SoporteColnodo/sensor-PM-SDS011/README.md

# Sensor-aire-rds
 Mediante esta pagina se pueden consultar los resultados del sensor de aire a tiempo real
 https://api.rds.org.co/reportes?categoria=sensor-aire
