SoporteColnodo/sensor-PM-SDS011/Manual técnico sensor material particulado.pdf

## ALERTAS AMBIENTALES: MANUAL TÉCNICO Y DE ENSAMBLAJE SENSOR PM 10 Y PM 2.5

¿Por qué nace el proyecto?

Este proyecto se enmarca dentro del concepto de las ciencias ciudadanas, una herramienta donde las comunidades son parte fundamental de cualquier investigación y participan activamente en el proceso de recolección y análisis de datos sobre problemáticas que afectan su calidad de vida, haciendo uso de sensores de bajo costo y accesibles.

Estos dispositivos están al servicio de comunidades para abordar ciertas preocupaciones como la contaminación por material particulado y sus integrantes pueden hacer uso de estos recursos informativos, trabajarlos, compartirlos y apropiarse de ellos en la defensa de sus territorios. En este manual se describen los elementos y pasos necesarios ensamblar un sensor de material particulado, que captura datos de PM 10 y PM 2.5, acompañados de coordenadas (latitud y longitud), identificación del sensor, fecha y hora, para ser almacenados dentro de una tarjeta microSD o ser enviados al servidor de mapas.

Elementos que componen el sensor de material particulado

Los elementos necesarios para ensamblar el sensor de ruido serán descritos a continuación:

- Microcontrolador

Una placa ESP32 (Figura 1), la cuál es un microcontrolador de 32 bits mucho más robusto y económico en procesamiento, módulos hardware y resolución ADC al contar con un conversor de 12 bits en vez de uno de 8 bits. Se opta por esta opción debido a la cantidad de módulos que irán ensamblados, capacidad de procesamiento y precisión de lecturas frente al Arduino MEGA y Arduino UNO. Se recomienda no hacer uso de las ESP 32 blancas.

Para su configuración, es necesario instalar un firmware en concreto para poder hacer uso de la tarjeta desde el IDE de Arduino, que será explicado más adelante.

- Sensor de posición

El sensor GPS propuesto es el Neo 6M (Figura 2) que funciona por comunicación serial UART. Tiene conexión directa satelital, motivo por el cual la lectura es bastante precisa y eficiente cuando inicia el proceso de lectura.

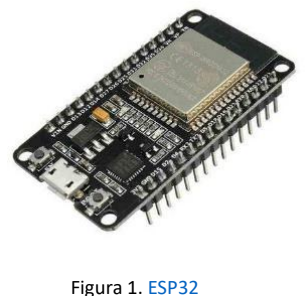
[picture p1: figure]

Figura 1. ESP32 (https://ferretronica.com/products/modulo-wifi-bluetooth-esp32)

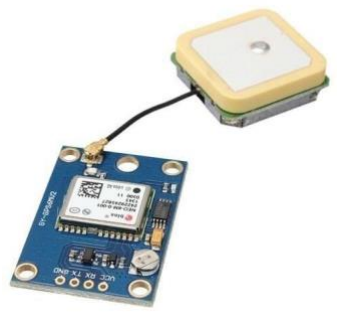
[picture p2: figure]

Figura 2. Sensor GPS Neo 6M (https://articulo.mercadolibre.com.co/MCO-452780792-modulo-gps-para-arduino-neo-6m-_JM)

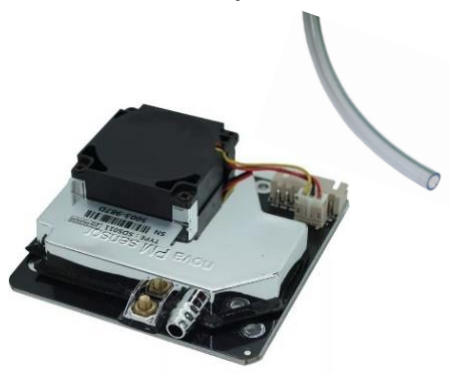
[picture p3: figure]

- Sensor de material particulado PM 10 y PM 2.5

Un sensor SDS011 Nova de PM (Figura 3), el cual captura material particulado de diámetro de 10 micrómetros y 2.5 micrómetros a partir de tecnología láser. En su interior contiene un ventilador, que de mayor tamaño al de otros sensores del mercado, lo cual implica que será mejor la calidad de los datos capturados

Es necesario adaptarle una manguera de diámetro 0.5 mm para la captura de aire.

- Reloj de tiempo real (RTC)

La captura de datos relacionados a la fecha y hora se hace a través de un módulo RTC DS1307 (figura 4) el cuál funciona por medio de la interfaz de comunicación I2C. Dicho módulo funciona perfectamente y es amigable para los usuarios; es importante que en las conexiones de I2C (SDA y SCL) se añadan resistencias de pull-up (10KOhm recomendado) para regular las diferencias de tensión.

- Lector de tarjeta SD

Para la tarjeta SD se utiliza un módulo de lectura/escritura de tarjeta SD, el cuál maneja protocolo de comunicación SPI. Hay que tener cuidado con este módulo ya que se vende el de tarjeta SD y microSD, los de tarjeta SD tienden a fallar por no estar bien adaptados a esos tamaños, cosa que no pasa con los microSD.

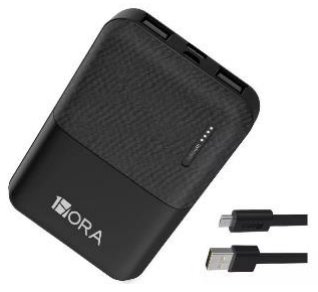
[picture p4: figure]

- Power Bank

PowerBank 5000 mAh dispositivo portátil para cargar dispositivos electrónicos mientras se está en movimiento. ofrece una fuente de energía adicional para teléfonos móviles, tabletas u otros dispositivos electrónicos (figura 6).

- Conector USB (Macho)

Conector que permite vincular diferentes elementos a través del Universal Serial Bus (USB), usado en el montaje para alimentar la tarjeta ESP32 de informacion y la corriente desde la power bank (figura 7).

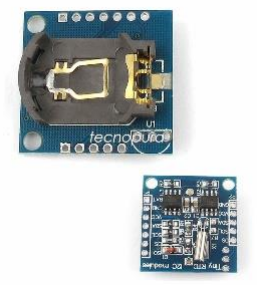
[picture p5: figure]
Figura 9. Power Bank

Figura 4. Módulo RTC DS1307 (https://www.tecnopura.com/producto/modulo-rtc-ds1307-reloj-en-tiempo-real-interface-i2c/)

Figura 3. Sensor (https://www.zamux.co/modulo-lectura-escritura-micro-sd) SDS011 Nova PM (https://www.mactronica.com.co/sensor-de-particulas-de-polvo-nova-pm-sds011)

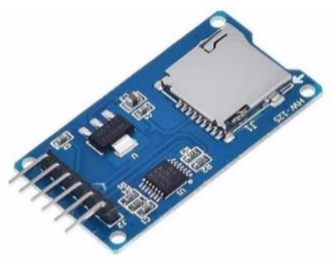
[picture p6: figure]

Figura 5. Módulo microSD (https://www.zamux.co/modulo-lectura-escritura-micro-sd)

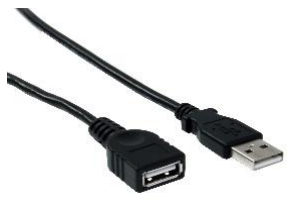
[picture p7: figure]

Figura 7. CABLES USB (https://www.mercadolibre.com.co/cable-sgl-extension-usb-3mts-a4s/p/MCO21521902)

Figura 6. Power Bank 500 mAh (https://articulo.mercadolibre.com.co/MCO-1200585124-power-bank-5000-mah-portable-original-1hora-facil-de-llevar-_JM)

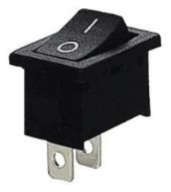
[picture p8: figure]

- Interruptor Encendido/Apagado

Mini Switch Interruptor Balancin 15mm x 10mm x 12mm para Chasis de 2 Pines y 2 Posiciones altamente empleado en Circuitos Electricos y Electronicos, usado en el prototipo en dar paso a la energia desde la power bank hacia el circuito (figura 8).

- Bornera de conexión con tornillo

Una clema (también conocido como bornera o regleta) es un tipo de conector eléctrico en el que un cable se aprisiona contra una pieza metálica mediante el uso de un tornillo.¹
Se implementa dentro del circuito para conexión cableada (figura 9).
- Cables de conexión para protoboard

Cables Dupont para Protoboard Macho/Macho, Hembra/Hembra, Macho/Hembra son cables jumper de 15cm de largo. Estos se usan para conectarse desde cualquier header hembra o macho en cualquier placa, usados dentro de el prototipo para la conexión de los módulos entre si y la protoboard.

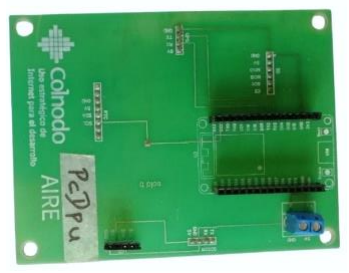
[picture p9: figure]

- PCB

Una PCB o Placa con circuito impreso, que funciona a manera de soporte fisico y de conexiones para ensamblar los componentes del dispositivo de ruido. Esta placa reemplaza la clasica protoboard con orificios que usa de pruebas y contiene las conexiones necesarias y esta contra marcada con logo de Colnodo.

- SD y adaptador

Un adaptador para tarjeta micro SD en el cual se almacenaran los archivos que se capturen con el sensor de ruido, esta tarjeta microSD tiene una capacidad de 8 gb (figura 12).

1 https://outletelectricidad.com/es/646-regletas-de-conexion

Figura 8. Interruptor
Encendido/Apagado (https://ferretronica.com/products/mini-switch-interruptor-balancin-15mm-x-10mm-x-12mm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)

Figura 9. Bornera de conexión con tornillo (https://articulo.mercadolibre.com.co/MCO-636537323-conector-terminal-bloque-bornera-kf302-2-pines-azul-tornillo-_JM)

Figura 10. Cables de conexión para protoboard (https://articulo.mercadolibre.com.co/MCO-623042255-cables-jumpers-m-h-10cm-x-40-unidades-_JM)

Figura 12. Adaptador
TarjetaMicro SD (https://www.mercadolibre.com.co/tarjeta-de-memoria-kingston-sdcs-canvas-select-con-adaptador-sd-32gb/p/MCO10359999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)

Figura 11. PCB

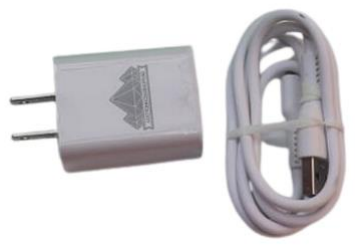
[picture p10: figure]
Figura 18. Cargador tipo 2

- Cargador y cable de conexión

El cargador funciona como un dispositivo que permite entregar corriente continua de bajo voltaje a otros dispositivos como es el caso de la Power Bank y recargarla; para transferencia de codigo tambien. La entrada del cargador es tipo 2.

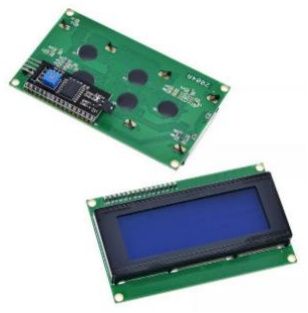
[picture p11: figure]

- Pantalla Display LCD

Una LCD o pantalla de cristal líquido, de referencia 4x20, es un componente que facilita la visualización de información o datos de una forma gráfica, haciendo uso de caracteres y símbolos configurados desde el código de programacipón en Arduino IDE (figura 14).

Esquemático de conexiones

A partir de pruebas realizadas en el circuito de pruebas, se propone el siguiente esquemático de conexiones para alimentar cuatro módulos respectivos y componentes pasivos como los diodos LED, condensadores, bornera y resistencias.

Figura 13. Cargador tipo 2

Figura 13. Pantalla LCD 4X20 (https://ferretronica.com/products/pantalla-display-lcd-4x20-verde)

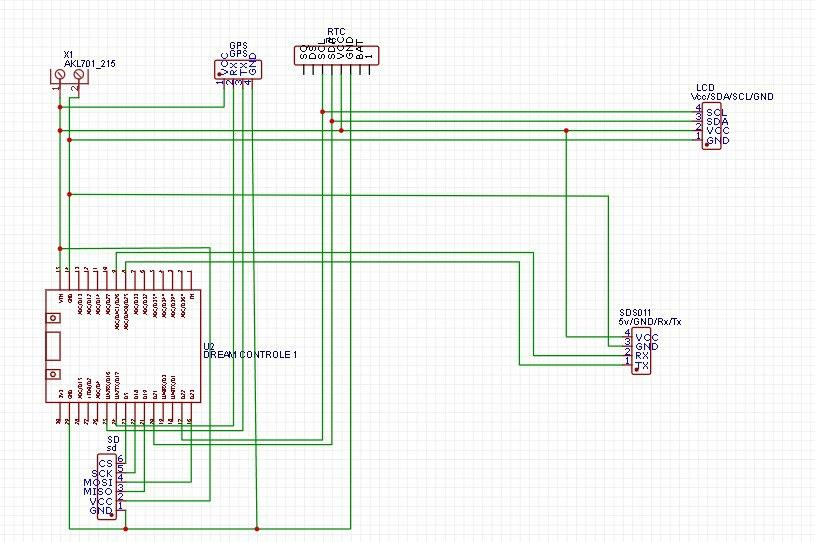
[picture p12: figure]

Diseño PCB (Placa con circuito impreso)

El diseño ha sido realizado en el software libre EasyEDA²
, en cual se pueden crear y simular circuitos para posteriormente diseñar la placa de circuito impreso y generar el archivo para su impresión.

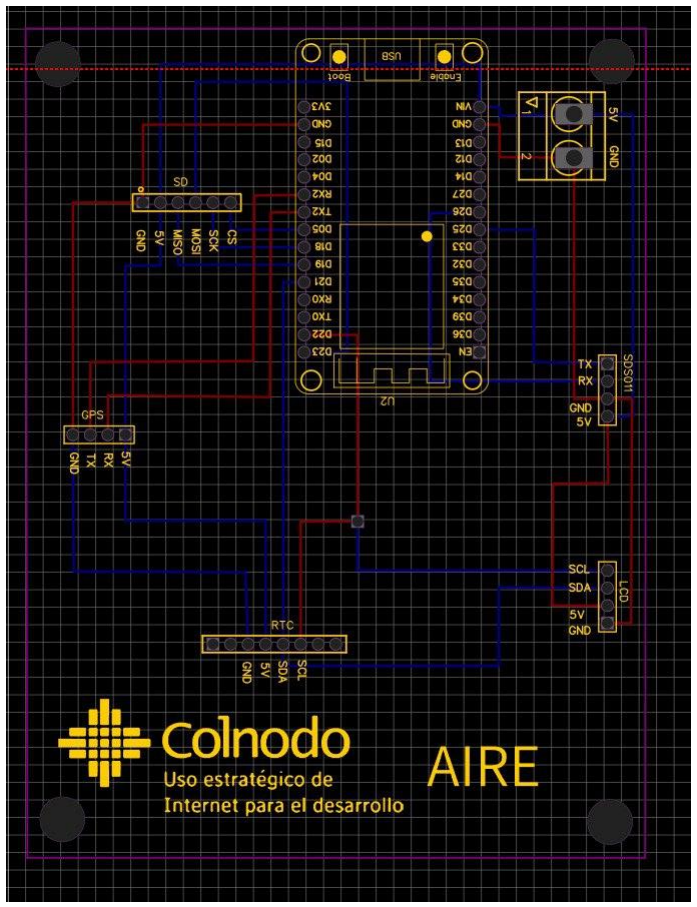
[picture p13: figure]

Enlace de descarga: https://easyeda.com/page/download

Esquemático en 3D

El diseño de esta PCB es de capa doble con conexiones y puntos de contacto en ambas caras, con la finalidad de que cada uno de los módulos encaje correctamente y contenga las conexiones correctas entre estos. A continuación, la vista por ambas caras:

2 Documentación para consultar: https://docs.easyeda.com/en/FAQ/Editor/index.html#Video-Tutorials

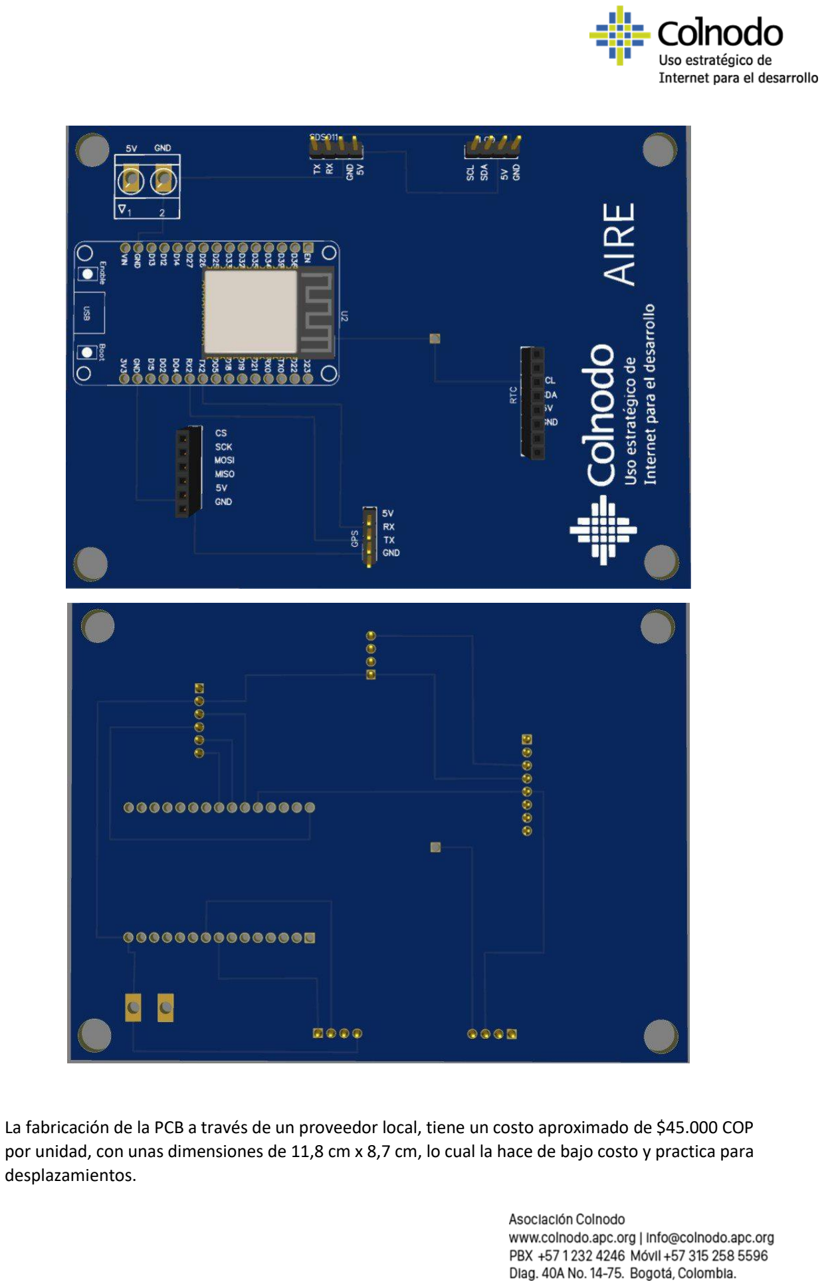
[picture p14: page 6]

La fabricación de la PCB a través de un proveedor local, tiene un costo aproximado de $45.000 COP por unidad, con unas dimensiones de 11,8 cm x 8,7 cm, lo cual la hace de bajo costo y practica para desplazamientos.

Archivo de la PCB: https://nube.colnodo.apc.org/index.php/s/MrLtsyfC2da3JpN

Ensamblaje y conexiones

En ensamblaje del sensor contempla los elementos descritos anteriormente y algunas herramientas adicionales como un kit de soldadura básico, destornilladores y pinzas de corte.

Tener en cuenta que la Bornera necesita soldarse, los módulos y otros componentes del sensor se realizan a través de conexiones entre los pines haciendo uso de cables de conexión, regletas de pines y soldadura de doble capa en la PCB.

Imagen de referencia ESP 32 con sus respectivos pines y funciones asociadas:

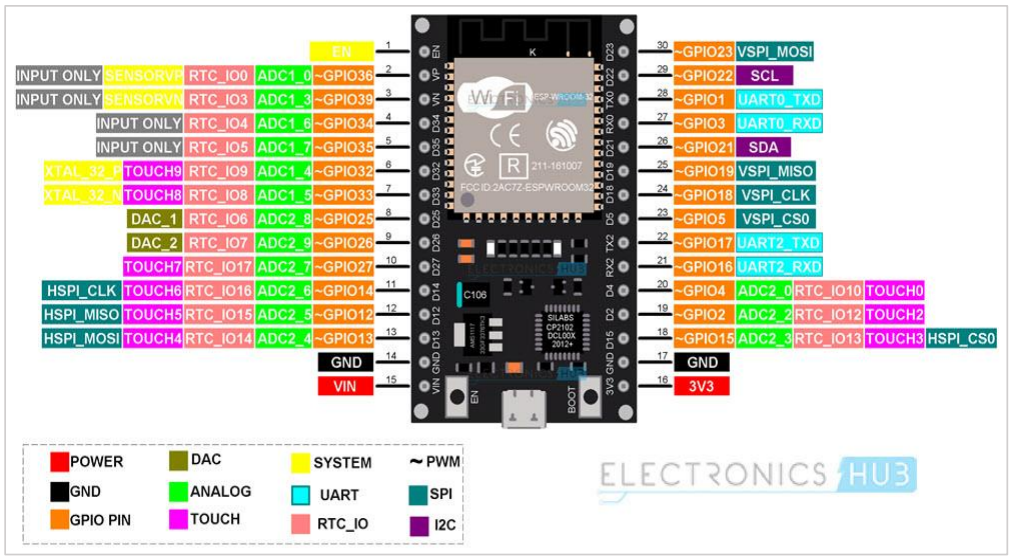
[picture p15: figure]

Vista frontal ensamblada:

1. Microcontrolador ESP 32: regleta y soldadura doble capa (pines arriba y abajo)
2. Bornera: ensamblada aplicando soldadura en ambas caras de la PCB.
3. Módulo GPS: Regleta y soldadura de doble capa

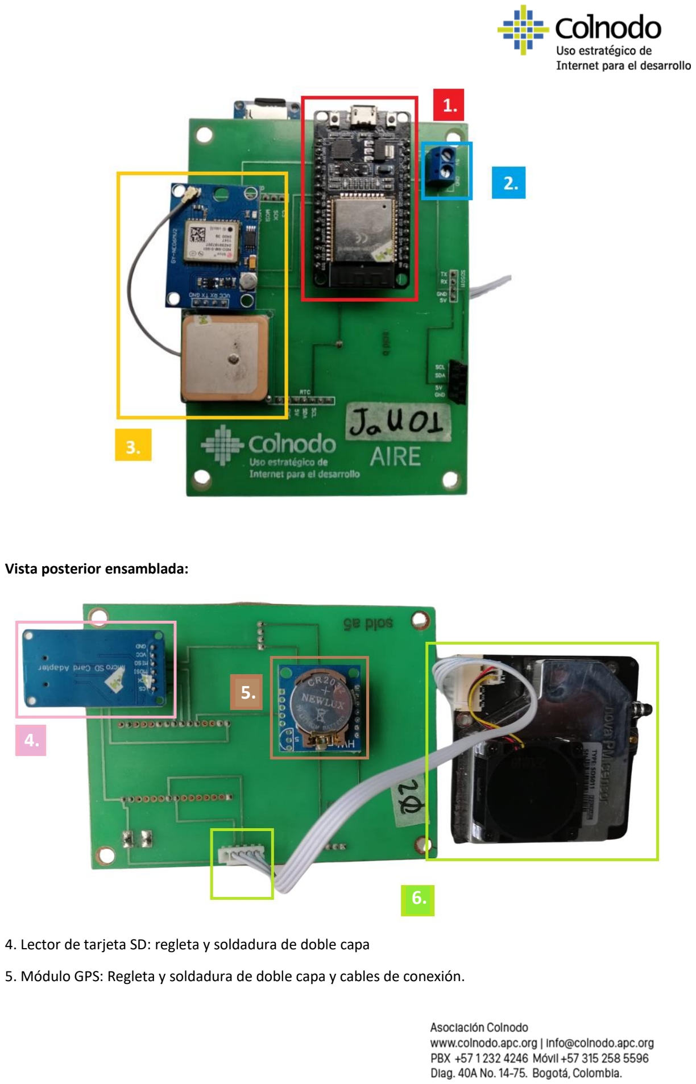
[picture p16: page 8]

Vista posterior ensamblada:

4. Lector de tarjeta SD: regleta y soldadura de doble capa
5. Módulo GPS: Regleta y soldadura de doble capa y cables de conexión.

6.

5.

4.

6. Sensor de material particulado: Regleta y soldadura de doble capa.

Arduino IDE y Código de programación

El código de programación del dispositivo para capturar los niveles de ruido ha sido construido y trabajado en software de Arduino IDE ³
, un software libre que funciona como un entorno de programación en lenguaje C#. Enlace de descarga: https://www.arduino.cc/en/software

Una vez que el Arduino IDE esté instalado, es necesario continuar la instalación de las librerías ⁴ y
controladores USB esenciales para que el computador pueda comunicarse correctamente con la placa ESP 32 a través del puerto USB, como indica la documentación recomendada en el pie de página. El código de programación se encuentra disponible para ser descargado en el siguiente enlace: https://github.com/SoporteColnodo/sensor-PM-SDS011

Al momento de ser ejecutado, encontrará que consta de nueve pestañas dispuestas de la siguiente manera y manejado en una estructura de C# de void setup y void loop:

- api-rest-rds.ino:

Pestaña principal donde se inicia la ejecución del sensor y los módulos (objetos y variables globales para el sistema), desde acá se llaman librerías y funciones que están en otras pestañas para que se ejecuten, los parámetros del módulo GPS y también la impresión de mensajes de estado en monitor serial y en la pantalla LCD.

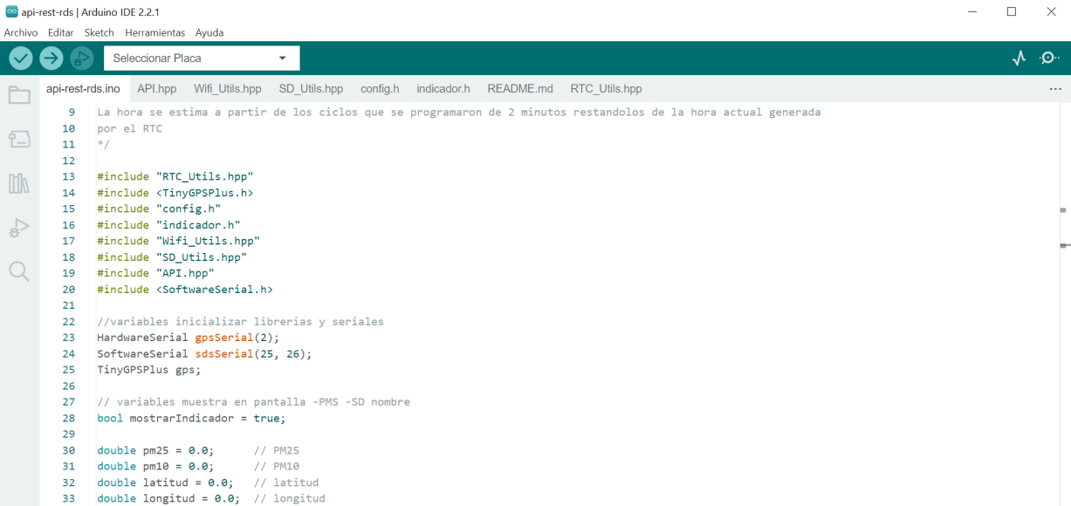
[picture p17: figure]

3 Documentación adicional y de consulta:
Programar ESP32 con Arduino IDE: https://programarfacil.com/esp8266/programar-esp32-ide-arduino/ Actualizar drivers, conexiones USB para que reconozca la ESP32: https://www.silabs.com/developers/usb-to-uart-bridge-vcp-drivers?tab=downloads (https://www.silabs.com/developers/usb-to-uart-bridge-vcp-drivers?tab=downloads)
ESP 32 Arduino: https://estudiomiranda.github.io/ESP32/guia/#configuracion
4 Enlace de descarga a las librerías: https://nube.colnodo.apc.org/index.php/s/HjqYNo4RBpBLTRK

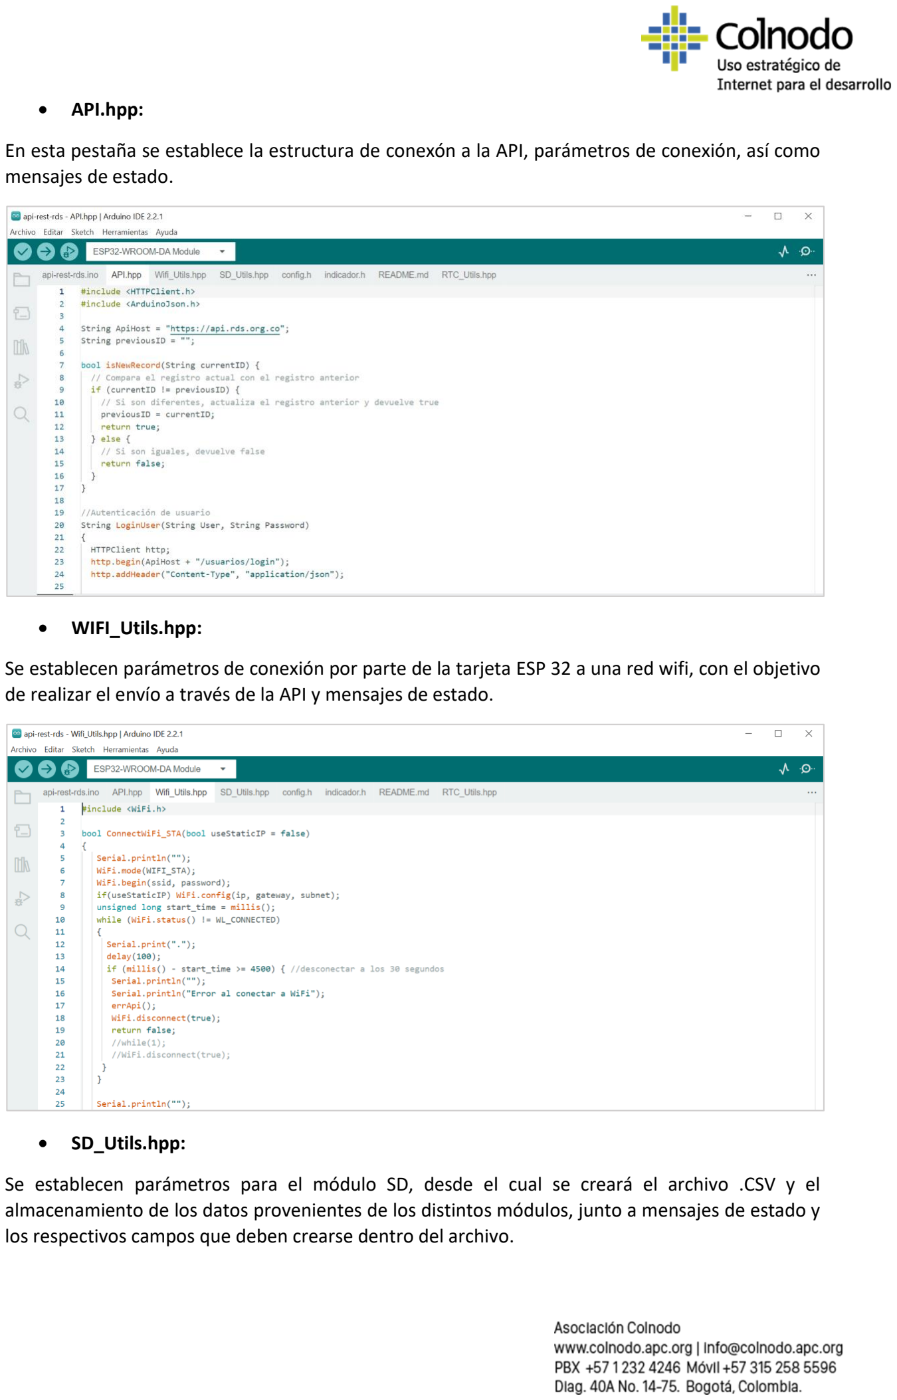
[picture p18: page 10]

- API.hpp:

En esta pestaña se establece la estructura de conexón a la API, parámetros de conexión, así como mensajes de estado.

- WIFI_Utils.hpp:

Se establecen parámetros de conexión por parte de la tarjeta ESP 32 a una red wifi, con el objetivo de realizar el envío a través de la API y mensajes de estado.

- SD_Utils.hpp:

Se establecen parámetros para el módulo SD, desde el cual se creará el archivo .CSV y el almacenamiento de los datos provenientes de los distintos módulos, junto a mensajes de estado y los respectivos campos que deben crearse dentro del archivo.

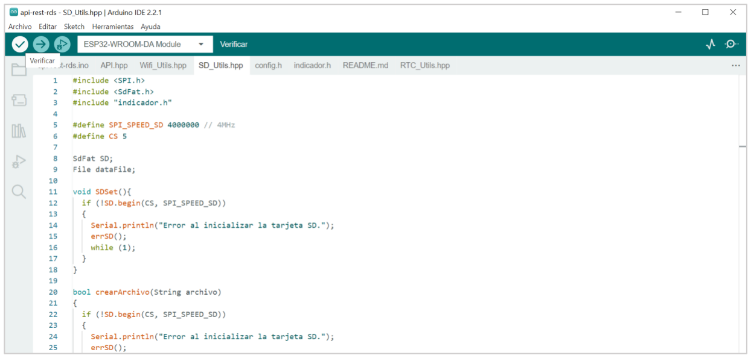
[picture p19: figure]

Acá también se establece el tipo de campo y separadores decimales.

- Config.h:

Se establecen parámetros para asignar una red wifi a la cual se conectará, ingresando un usuario y contraseña y un nombre del sensor, usuario y contraseña para conectar a la API. Desde esta pestaña también se establece el nombre del archivo o archivos a crear para guardar los datos, la frecuencia de tiempo para la captura, almacenamiento y envío de datos tanto a la SD como a la API.

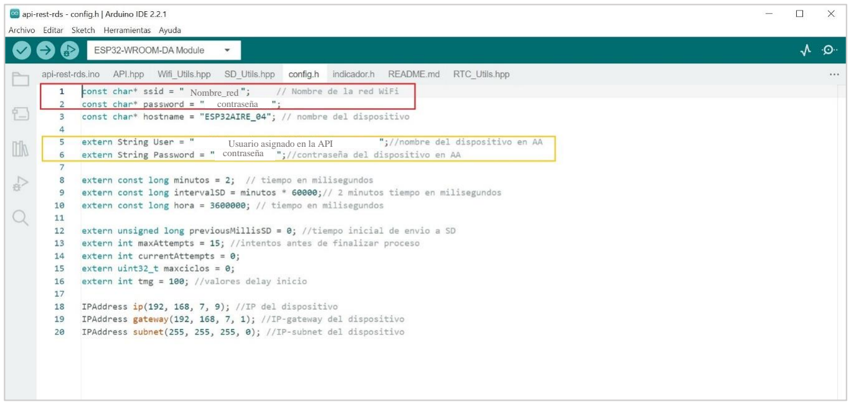
[picture p20: figure]
Nombre_red contraseña; contraseña; Usuario asignado en la API

Importante: Es necesario reemplazar los datos de la red Wifi (Nombre de la red y contraseña con sus respectivos caracteres) y los datos del sensor previamente registrados en la API de Colnodo.

- Indicador.h:

En esta pestaña se establecen parámetros para los mensajes que se reflejaran en la pantalla LCD, de manera que se muestren datos de PM 2.5, PM 10, latitud y longitud. Si el mensaje cambia indicara lo que está sucediendo con el sensor (envío a la API, guardar en CSV o si falla la SD).

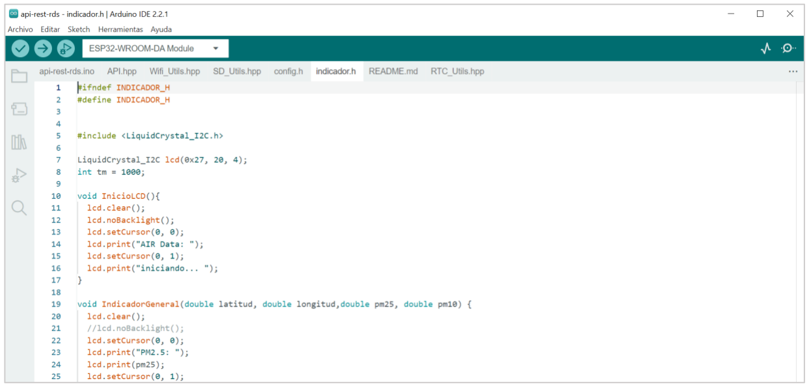
[picture p21: figure]

- README.md:

Acá se encontrará el enlace de la ventana de visualización para visualizar el envío de datos a la API.

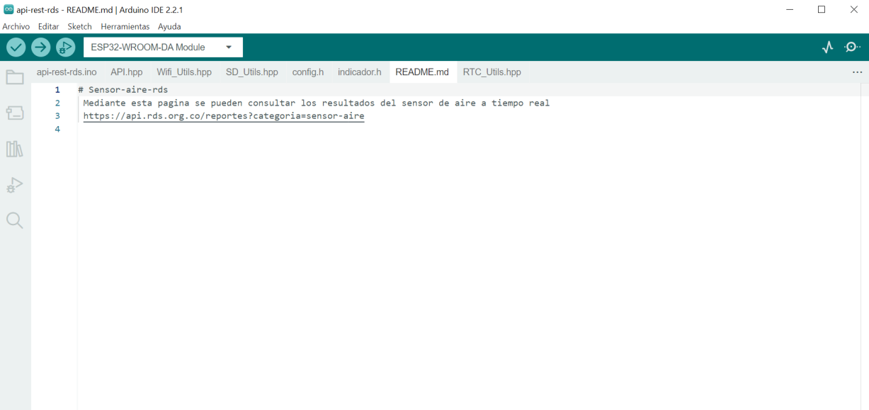
[picture p22: figure]

- RTC_Utils.hpp:

Se establecen los parámetros del módulo RTC, la conexión, librerías necesarias, mensajes de estado y configuración de formato para la hora y fecha del módulo.

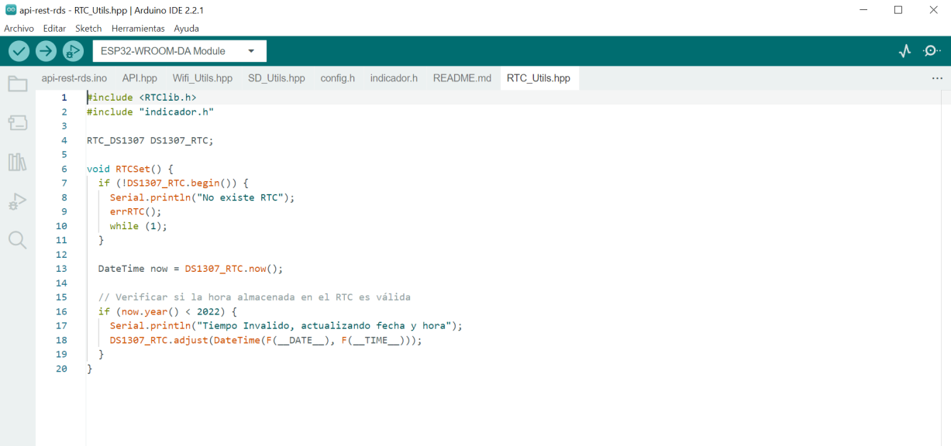
[picture p23: figure]

Caja contenedora

La caja contenedora actúa como un compartimiento protector para el dispositivo y los diferentes componentes que están ensamblados a las placas de circuito impreso (PCB), al tiempo de ser adecuadas para su transporte y uso en campo.

La tecnología de impresión en 3D permite que, a partir de un diseño previamente realizado en el software de AutoCAD, se cree este prototipo en forma de caja cuadrada, compuesta de varios compartimientos para ubicar los elementos del dispositivo y permitir comunicación externa del sensor para la captura de material particulado, conectar a una fuente de alimentación eléctrica el dispositivo y dejar expuesto el módulo del sensor de ruido.

Vista del diseño:

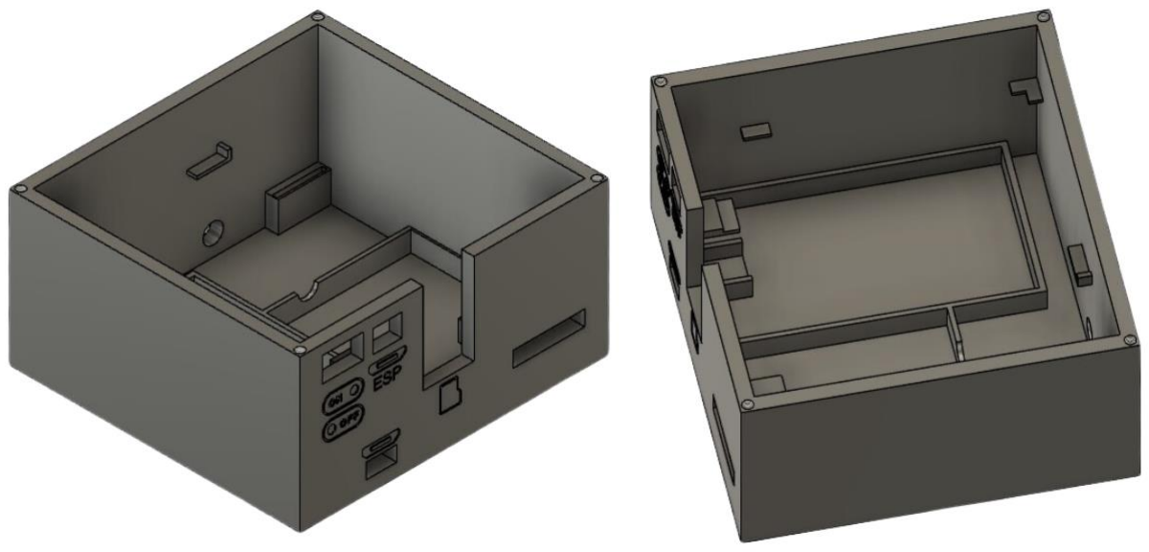
[picture p24: figure]

Caja contenedora impresa y en uso:

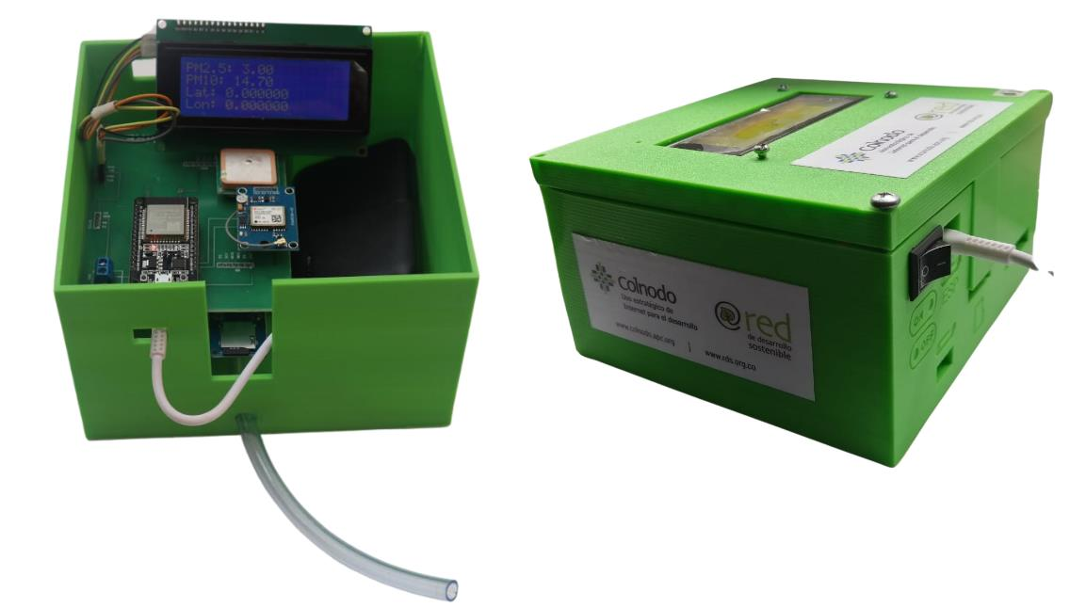
[picture p25: figure]

La caja posee unas dimensiones de 15.2 cm x 14 cm x 7 cm y la tapa de 15.2 cm x 14 cm x 1 cm, en su exterior se encuentra el interruptor de encendido/apagado para su funcionamiento y esta identificada con logos correspondientes a la organización.

Archivo del diseño: https://nube.colnodo.apc.org/index.php/s/MrLtsyfC2da3JpN

Captura de datos /salida de datos

La captura de datos puede ser comprobada de tres formas generales:

Micro SD:

La captura de datos se realiza mediante el módulo de Micro SD en el cual se crea un archivo en formato CSV de almacenamiento denominado con la fecha de captura, de tal forma que sea un archivo de bajo peso para su almacenamiento o envío. Dentro del archivo los datos se listan separados por coma (,).

- PM25: Almacena los valores de material particulado de diámetro de 2.5 micrómetros, capturados por el sensor de partículas.
- PM10: Almacena los valores de material particulado de diámetro de 10 micrómetros, capturados por el sensor de partículas.
- Latitud: Datos de latitud capturados a partir del módulo GPS.
- Longitud: Datos de longitud capturados a partir del módulo GPS.

- Fecha: fecha en la que el dato se almacena Año/Mes/Dia, datos obtenidos del módulo RTC
- Hora: Hora establecida para ser almacenada Horas/Minutos/Segundos, datos tomados del módulo RTC.

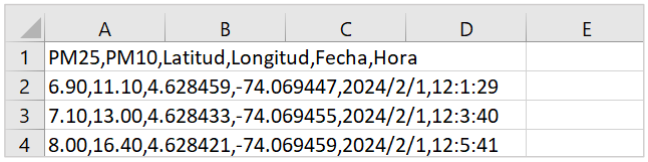
[picture p26: figure]

Los datos almacenados pueden ser trabajados y graficados a través de diferentes programas; los nombres de los campos son configurados sin caracteres especiales como puntos, comas, tildes, etc. Para evitar conflictos con el servidor.

Sistema de Información geográfico de la RDS:

Los datos capturados a través del dispositivo son enviados a través de la API y almacenados en un archivo tipo GeoJSON. Este permite representar cada dato capturado en un elemento geográfico sobre un mapa junto con sus atributos o características como la hora, fecha, medida, etc. A partir de sus coordenadas de latitud y longitud.

El archivo ha sido configurado dentro de QGIS, para representar cada captura dentro del proyecto “Material particulado”, disponible en:

https://rds.org.co/es/alertas-ambientales/alertas-dispositivo-aire

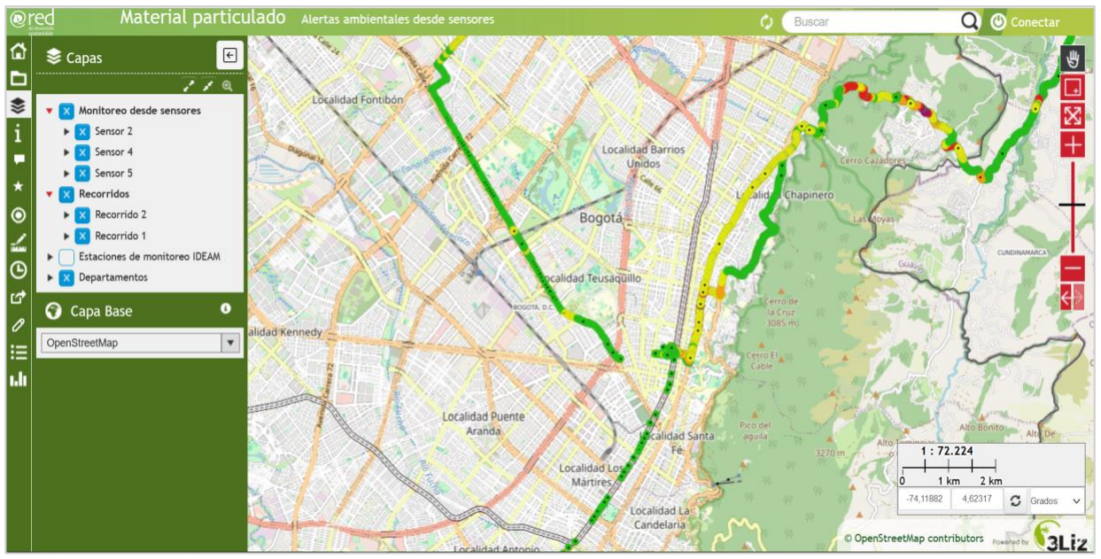
[picture p27: figure]

Cada captura está asociada a un número de dispositivo asignado para su identificación y pueden consultarse o descargarse a través de diversas herramientas que ofrece la interfaz, una de ellas Datos, que está localizada en el panel lateral izquierdo con el siguiente icono:

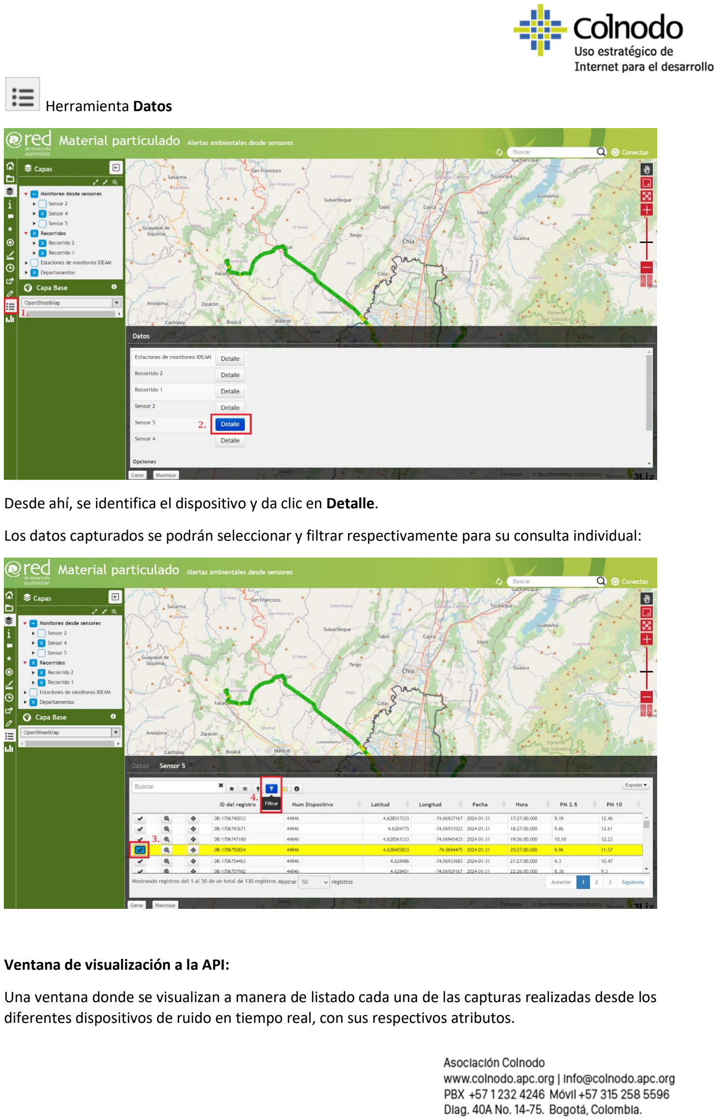
[picture p28: page 16]

Herramienta Datos

Desde ahí, se identifica el dispositivo y da clic en Detalle.

Los datos capturados se podrán seleccionar y filtrar respectivamente para su consulta individual:

Ventana de visualización a la API:

Una ventana donde se visualizan a manera de listado cada una de las capturas realizadas desde los diferentes dispositivos de ruido en tiempo real, con sus respectivos atributos.

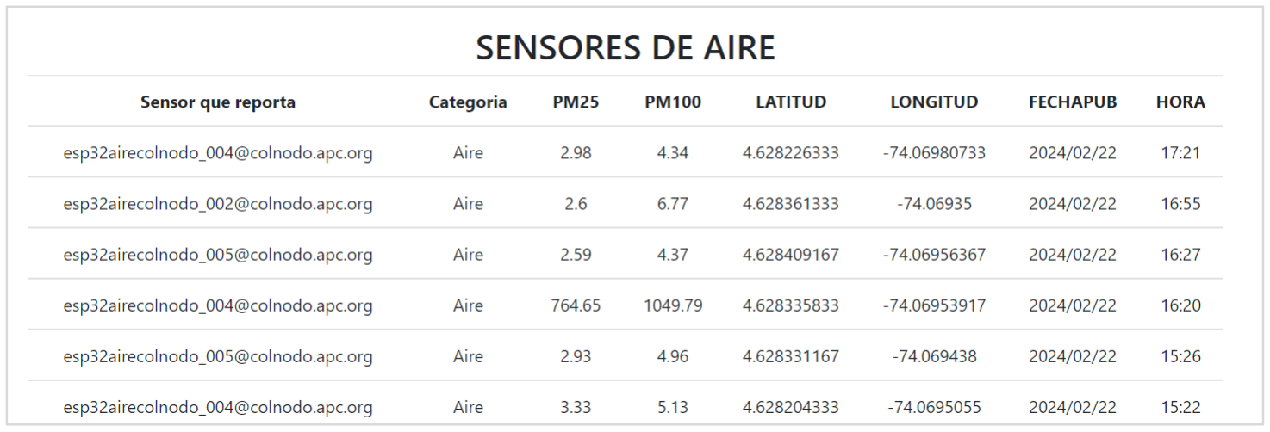
[picture p29: figure]

Enlace de visualización: api.rds.org.co/reportes?categoria=sensor-aire

Recomendaciones

Mantener alejada la manguera del sensor de material particulado de superficies calientes que puedan derretir; evitar introducir elementos que puedan obstaculizar el paso del aire.

Evitar golpes o rayones sobre la pantalla LCD que puedan afectar su funcionamiento o visibilidad de los datos en esta.

Para la conexión a una red Wifi dentro del código, es indispensable conocer el nombre y contraseña de la red a la cual se desea conectar; se recomiendan redes no superiores a 2.4G.

El dispositivo deberá mantenerse alejado de líquidos o superficies húmedas, ya que, al tener sus componentes expuestos, podría resultar en daño de algunos de los módulos o daño completo del dispositivo; no exponer a ubicaciones que causen caída o golpes.

En caso de que el dispositivo mantenga una ubicación fija, se recomienda hacer verificación periódica de funcionamiento y carga de corriente de la batería.

Mantener el dispositivo dentro de su caja.
