SoporteColnodo/sensor-PM-SDS011/RTC_Utils.hpp

#include <RTClib.h>
#include "indicador.h"

RTC_DS1307 DS1307_RTC;

void RTCSet() {
  if (!DS1307_RTC.begin()) {
    Serial.println("No existe RTC");
    lcd.clear();
    lcd.setCursor(0, 0);
    lcd.print("No existe RTC");
    errRTC();
    while (1);
  }
  
  DateTime now = DS1307_RTC.now();

  // Verificar si la hora almacenada en el RTC es válida
  if (now.year() < 2022) {
    Serial.println("Tiempo Invalido, actualizando fecha y hora");
    DS1307_RTC.adjust(DateTime(F(__DATE__), F(__TIME__)));
  }
}
