SoporteColnodo/sensor-PM-SDS011/(commit log)

2024-01-30 update repositorio de aire rds
2024-02-23 manual tecnico sensor material particulado
    manual tecnico sensor material particulado
2024-05-31 se realiza optimizacion del codigo en secciones para la toma de datos, se implementa la lectura de un archivo txt que permita cambiar el usuario y contraseña de la red wifi a la cual conectar apartir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
